DeeEmm/Marlin-CNC-Pendant/docs/MCP4151.png

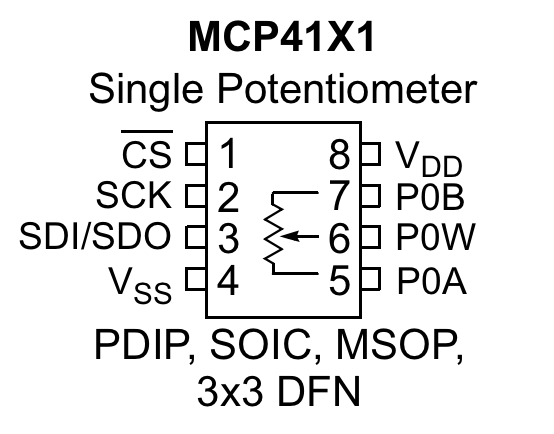
docs/MCP4151.png
