DeeEmm/Marlin-CNC-Pendant/(threads)

Thread 1 (2019-12-21):

Scaling of output

DeeEmm, 2019-12-21:
Need to determine correct scaling for outputs and how this can be integrated with move vector value.

DeeEmm, 2019-12-27:
Output scaling currently written as speed multipliers - 1x 10x 100x

This may need to be changed but requires testing to determine.

DeeEmm, 2019-12-30:
Changed speed multipliers for fixed speed values.

Closed 2019-12-30.

Thread 2 (2019-12-27):

Direction decide artifacts

DeeEmm, 2019-12-27:
Bench testing shows artifacts present in direction decode.

Essentially if jog wheel is rotated in one direction and then stopped. When the wheel is jogged in opposite direction the encoder buffer still contains data and will output three pulses of incorrect direction.

Possible solutions:

- Improve decode function
- Ignore initial pulses
- Empty encoder buffer

DeeEmm, 2019-12-27:
Changed decode function

Closed 2019-12-27.

Thread 5 (2019-12-30):

Speed referenced encoder output

DeeEmm, 2019-12-30:
Make output value proportional to speed encoder is being turned.

This will allow user to directly control speed of movement

DeeEmm, 2019-12-31:
Implemented - Build 19123101
Mode can be enabled / disabled by input pin and overrides standard speed control.
Can therefore be controlled by same rotary speed switch

Closed 2019-12-31.

Thread 8 (2024-02-01):

MPG Pedant jogging without using DAC/ADC interface (connected directly to ARDUINO MEGA2560 running Marlin)

FGSikasa, 2024-02-01:
Hi Michael, i am working on Marlin project with a mpg pendant directly connected to a ARDUINO MEGA2560. The connection is on PK0 /PCINT16 and PK1/PCINT17. I am implementing a ISR similar to the one of endstops. Do you have an idea how to inject the jogging moves without having to mimic joystick movements with an ADC ? Can i just use the digital values you feed to  MCP4151 in the  " Joystick::inject_jog_moves()  " as the raw values ?
I would be very greatful for your help / input !
Regards,
Phillip
