DeeEmm/Marlin-CNC-Pendant/(commit log)

2019-12-27 Build 19122701
    - Bench test complete
    [configuration.h]
2019-12-27 Build 19122703
    - #1 Speed scaling added to code
    - #2 Direction artifacts
    [configuration.h]
2019-12-27 Build 19122801
    - Added X10 / X100 output smoothing
    - Added single-step
    [configuration.h]
2019-12-29 Build 19122801
    - Added C/R low pass filter and tweaked move values
    - Changed speed multipliers for fixed speed values
    - Added usage explaination and comments
    [configuration.h]
2019-12-30 Build 19123003.VCR
    - VCR control added
    - Tested and working with Marlin 2.0
    [configuration.h]
2019-12-30 MPC4151 Voltage Controlled Resistor Pin Map.
    Pin connections for MCP4151.
    Three devices are required - one for each axis, connected as follows:
    1 -CS (Chip Select) - Nano Pin 14/15/16 for X/Y/Z axis respectively
    2 - SCK (Clock) - Nano Pin 13 (SCK) for all devices
    3 - SDI/SDO (Serial) - Nano Pin 11 (MOSI) for all devices
    4 - GND (0V)
    5 - GND (0v)
    6 - Wiper out - Connect to the X/Y/Z axis input on your RAMPs/3D printer controller
    7 - VCC (5v)
    8 - VCC (5v)
2019-12-30 Build 19123003
    - Updated comments
    [configuration.h]
2019-12-31 Build 19123101 - RC1
    - Release Candidate 1
    - #5 - Fine tuned adaptive speed function
    - #6 - Changed encoder interrupt routines to utilise bitread (faster)
    - General code tidy
    [configuration.h]
2020-01-01 Create MCP4151 Pin Connections
